Krishna-Gorai/small-soc-riscv/tests/isa/riscv-tests/README.md

Vendored from https://github.com/riscv-software-src/riscv-tests (commit 2ebecad, 2026-08-14),
directories `isa/rv32ui`, `isa/rv64ui`, `isa/macros/scalar`. BSD licence, see LICENSE.
The target environment (`riscv_test.h`, linker script) lives one level up in `../env/`.
