Krishna-Gorai/small-soc-riscv/rtl/regfile.v

`timescale 1ns/1ps
module regfile (
    input  wire        clk,
    input  wire [4:0]  rs1_addr,
    input  wire [4:0]  rs2_addr,
    input  wire [4:0]  rd_addr,
    input  wire [31:0] rd_data,
    input  wire        rd_we,
    output wire [31:0] rs1_data,
    output wire [31:0] rs2_data
);
    reg [31:0] regs [1:31]; // x0 is hardwired to 0, no storage needed

    assign rs1_data = (rs1_addr == 5'd0) ? 32'd0 : regs[rs1_addr];
    assign rs2_data = (rs2_addr == 5'd0) ? 32'd0 : regs[rs2_addr];

    always @(posedge clk) begin
        if (rd_we && rd_addr != 5'd0)
            regs[rd_addr] <= rd_data;
    end
endmodule
