Krishna-Gorai/small-soc-riscv/(commit log)

2026-09-15 Small_SoC: from-scratch RV32I+Zicsr SoC with AXI-Lite peripherals on ZCU104
    RTL: multicycle RV32I core with M-mode CSRs, ecall/ebreak/mret and a timer
    interrupt; AXI-Lite interconnect; 32 KB BRAM, GPIO, UART, timer slaves.
    Verification: riscv-tests rv32ui 41/41 in xsim via tests/isa/run_isa.py.
    Software: GCC toolchain (link.ld, crt0, trap vector, BSP), hello and
    irq_demo programs with self-checking simulation targets.
    FPGA: ZCU104 wrapper, constraints, non-project build flow; timing met at
    100 MHz, 1.5k LUT / 8 BRAM (reports in fpga/reports).
2026-09-15 Post-implementation functional simulation of the routed ZCU104 netlist
    fpga/write_netlist.tcl writes the post-route funcsim netlist; tests/tb/
    tb_zcu104_post.v drives the real 300 MHz clock and decodes the UART at
    115200 baud; scripts/run_postimpl.py runs it under xsim with unisims_ver.
    The netlist boots from the BRAM init and prints the banner (PASS at 610 us).
2026-09-15 JTAG debug port: halt/resume/reset, peek/poke, program load over JTAG
    rtl/jtag_tap.v: IEEE 1149.1 TAP (IDCODE/BYPASS/USER) with a BSCANE2-
    compatible user-register interface; rtl/jtag_dbg.v: 66-bit debug DR,
    TCK<->clk toggle synchronisers, AXI-Lite master, core halt/reset control;
    rtl/axi_lite_arbiter.v: core + debug two-master arbiter. Core gains a
    halt hook at the fetch boundary. zcu104_top uses BSCANE2 USER1 (no extra
    pins) with a TCK clock constraint; fpga/jtag_host.tcl drives it from the
    Vivado hardware manager. tests/tb/tb_jtag.v + scripts/run_jtag.py: IDCODE,
    halt, 382-word load with readback, reset, run, live peek -> PASS.
    ISA suite 41/41 and both programs unchanged.
    [axi_lite_arbiter.v, jtag_dbg.v, jtag_tap.v, riscv_core.v, run_jtag.py, soc_top.v, tb_isa.v, tb_jtag.v]
2026-09-15 Vivado project flow: run_project.tcl and impl_1/synth_1 reports
    Project runs (synth_1 -> impl_1 -> write_bitstream, default strategies)
    reproduce the non-project result: WNS +5.275 ns at 100 MHz, 1717 LUT /
    995 FF / 8 RAMB36. Reports kept in fpga/reports/project_flow/.
